ryanrahman27/rocky/model/meshes/hull_gripper_nojaws.stl

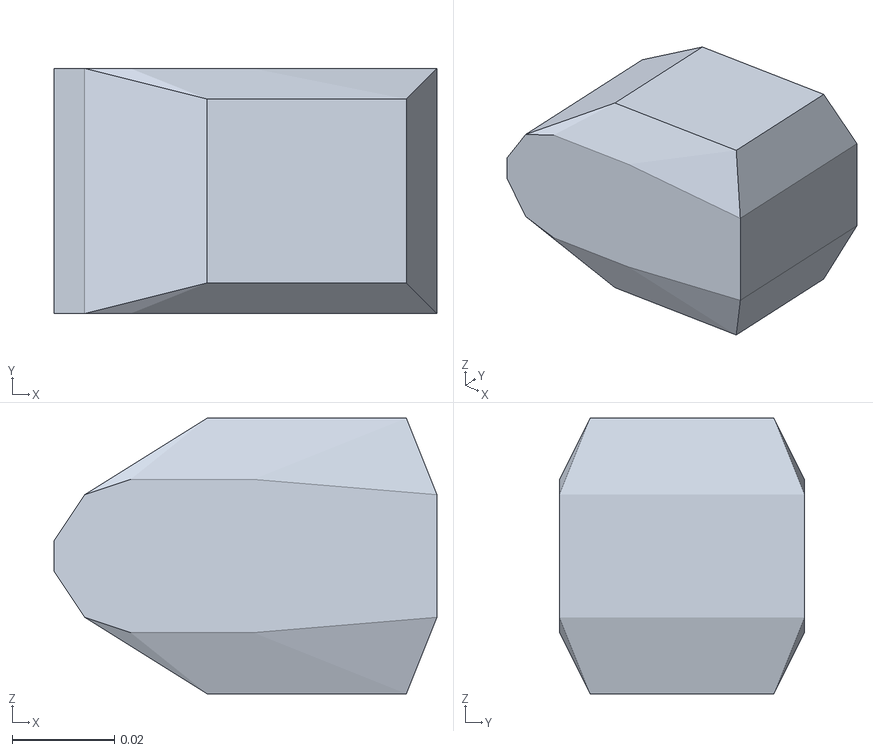
[picture p4: CAD file, 2026-09-15]
model/meshes/hull_gripper_nojaws.stl
0.075 x 0.048 x 0.054
