ryanrahman27/rocky/model/meshes/coxa_l1__F6700ZZ_SweepIdler.stl

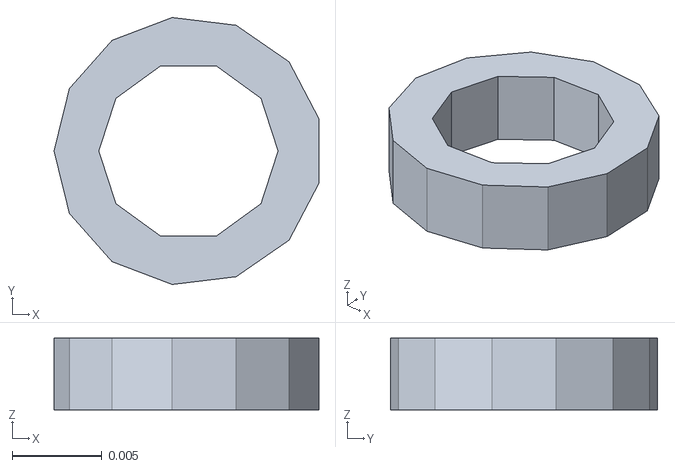
[picture p5: CAD file, 2026-09-13]
model/meshes/coxa_l1__F6700ZZ_SweepIdler.stl
0.0148 x 0.0149 x 0.004
