ryanrahman27/rocky/model/meshes/femur_l1__Horn_Elbow.stl

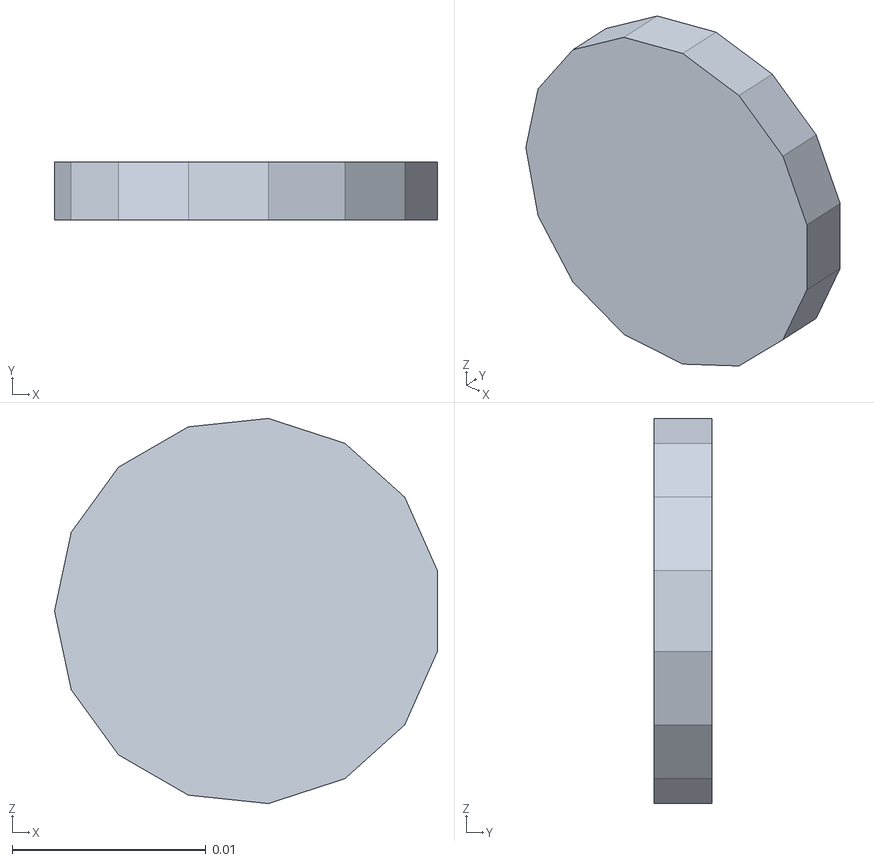
[picture p6: CAD file, 2026-09-13]
model/meshes/femur_l1__Horn_Elbow.stl
0.0198 x 0.003 x 0.0199
