ryanrahman27/rocky/model/meshes/hull_tibia_m.stl

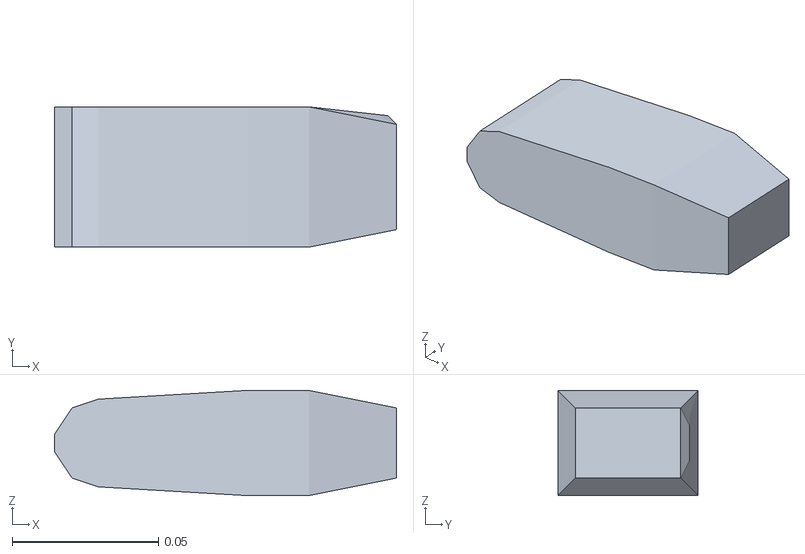
[picture p7: CAD file, 2026-09-13]
model/meshes/hull_tibia_m.stl
0.117 x 0.048 x 0.036
