ryanrahman27/rocky/model/meshes/hull_tibia.stl

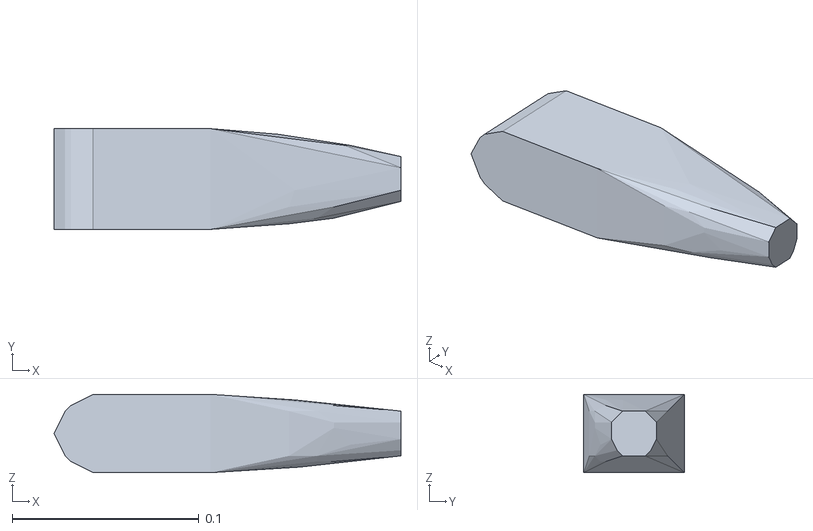
[picture p8: CAD file, 2026-09-13]
model/meshes/hull_tibia.stl
0.186 x 0.054 x 0.042
