ryanrahman27/rocky/model/meshes/base__Shoulder_Boot_3.stl

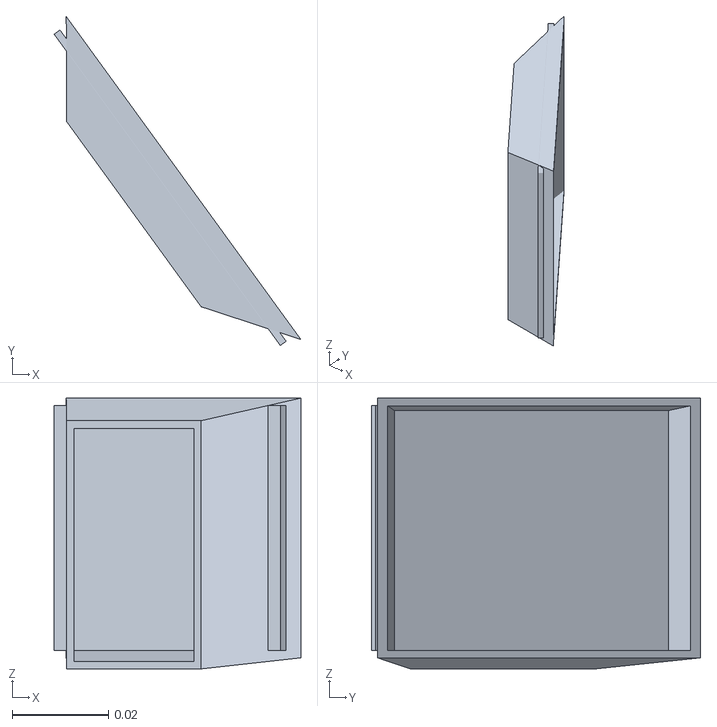
[picture p9: CAD file, 2026-09-13]
model/meshes/base__Shoulder_Boot_3.stl
0.0513 x 0.0684 x 0.0563
