ryanrahman27/rocky/model/meshes/femur_l1__Femur_Sleeve_Top.stl

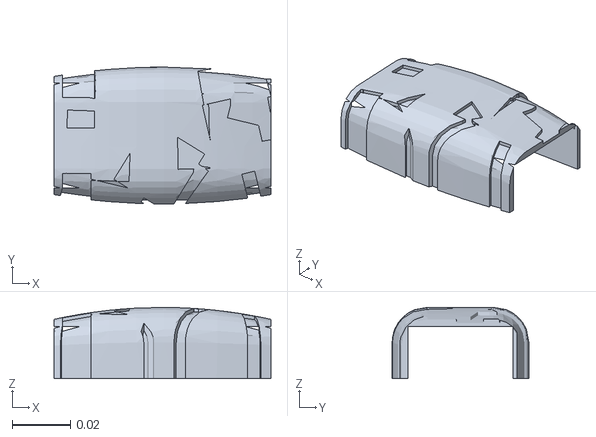
[picture p10: CAD file, 2026-09-13]
model/meshes/femur_l1__Femur_Sleeve_Top.stl
0.0746 x 0.047 x 0.0244
