ryanrahman27/rocky/model/meshes/tibia_m0__STS3215_Wrist.stl

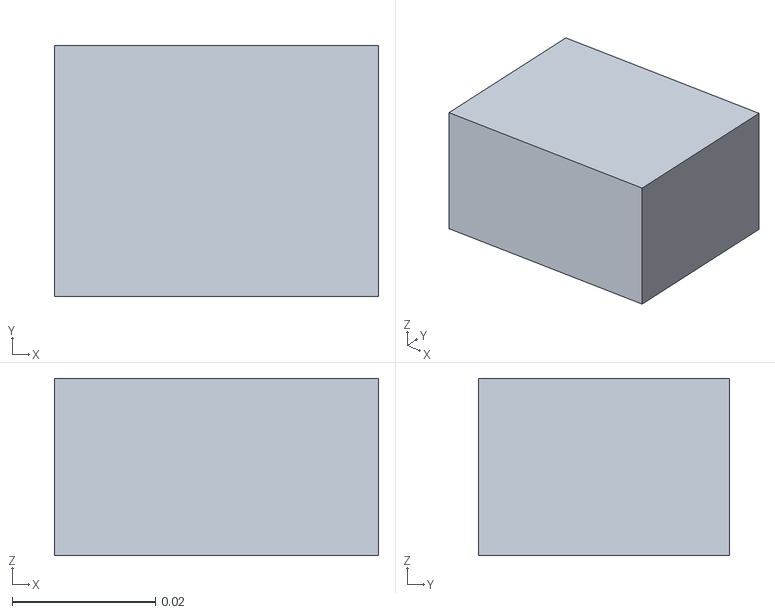
[picture p11: CAD file, 2026-09-13]
model/meshes/tibia_m0__STS3215_Wrist.stl
0.0452 x 0.035 x 0.0247
