ryanrahman27/rocky/model/meshes/base__Shoulder_Boot_4.stl

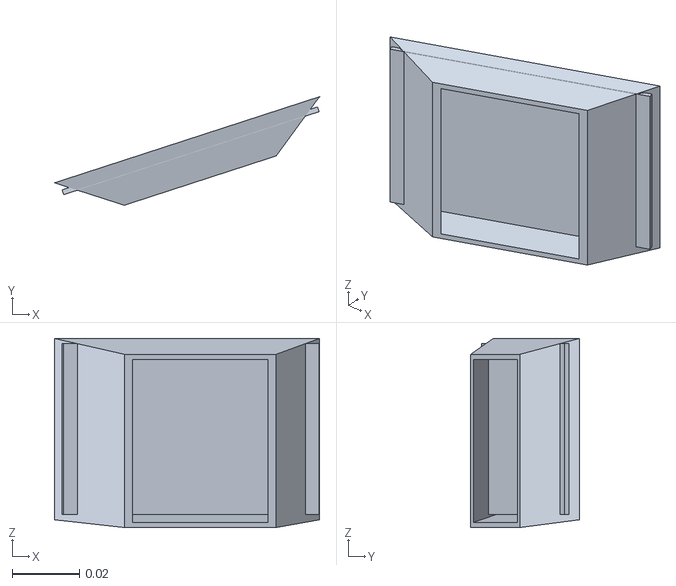
[picture p12: CAD file, 2026-09-13]
model/meshes/base__Shoulder_Boot_4.stl
0.0789 x 0.0323 x 0.0563
