ryanrahman27/rocky/model/meshes/tibia_l1__TactileSwitch_6x6.stl

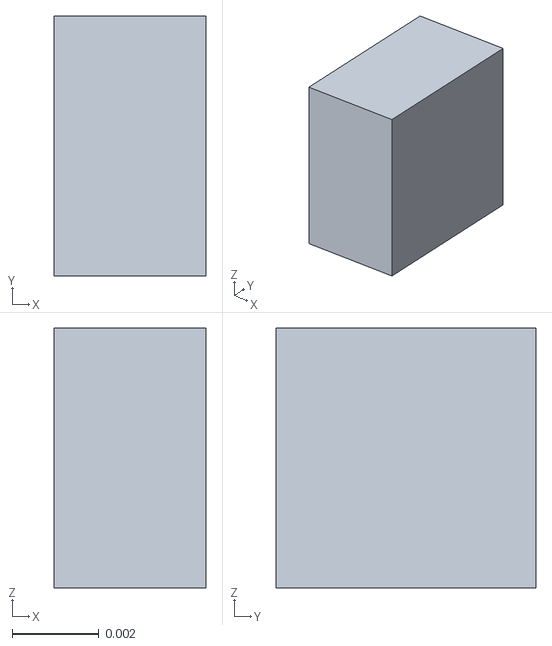
[picture p13: CAD file, 2026-09-13]
model/meshes/tibia_l1__TactileSwitch_6x6.stl
0.0035 x 0.006 x 0.006
