ryanrahman27/rocky/model/meshes/tibia_l1__Tibia_Sleeve_Top.stl

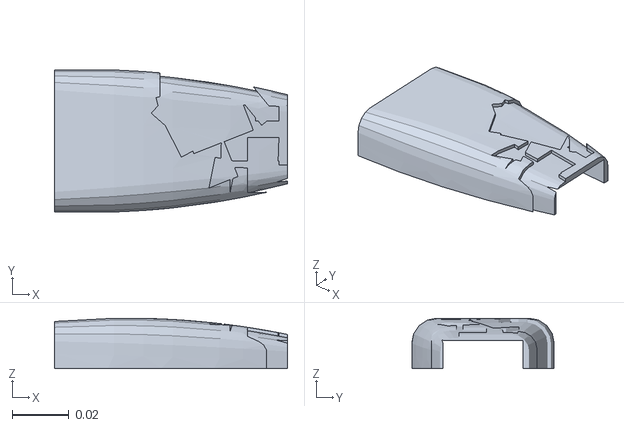
[picture p14: CAD file, 2026-09-13]
model/meshes/tibia_l1__Tibia_Sleeve_Top.stl
0.0818 x 0.05 x 0.0177
