ryanrahman27/rocky/model/meshes/gripper_m0__Jaw_L.stl

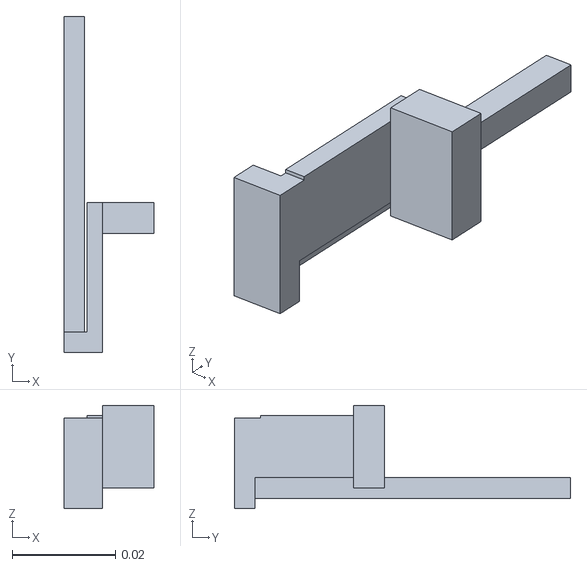
[picture p15: CAD file, 2026-09-13]
model/meshes/gripper_m0__Jaw_L.stl
0.0175 x 0.065 x 0.02
