ryanrahman27/rocky/model/meshes/gripper_m0__Foot_Pad_Manip.stl

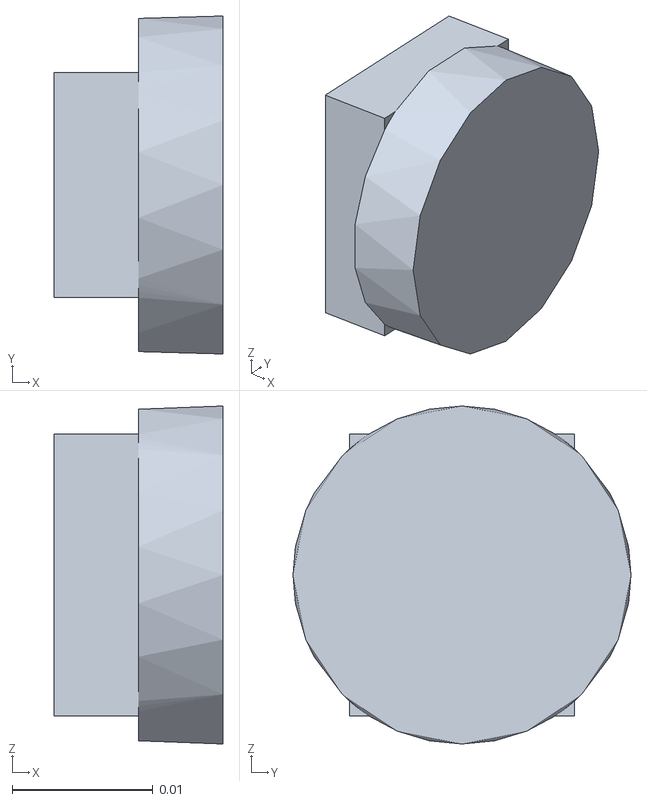
[picture p16: CAD file, 2026-09-13]
model/meshes/gripper_m0__Foot_Pad_Manip.stl
0.012 x 0.024 x 0.024
