ryanrahman27/rocky/model/meshes/hull_femur.stl

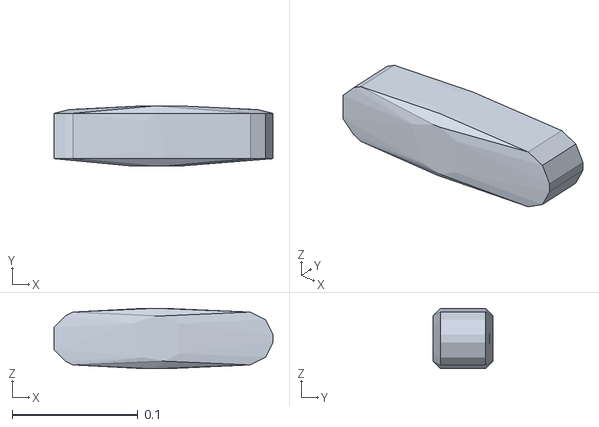
[picture p17: CAD file, 2026-09-13]
model/meshes/hull_femur.stl
0.174 x 0.048 x 0.048
