ryanrahman27/rocky/model/meshes/tibia_m0__Tibia_Manip.stl

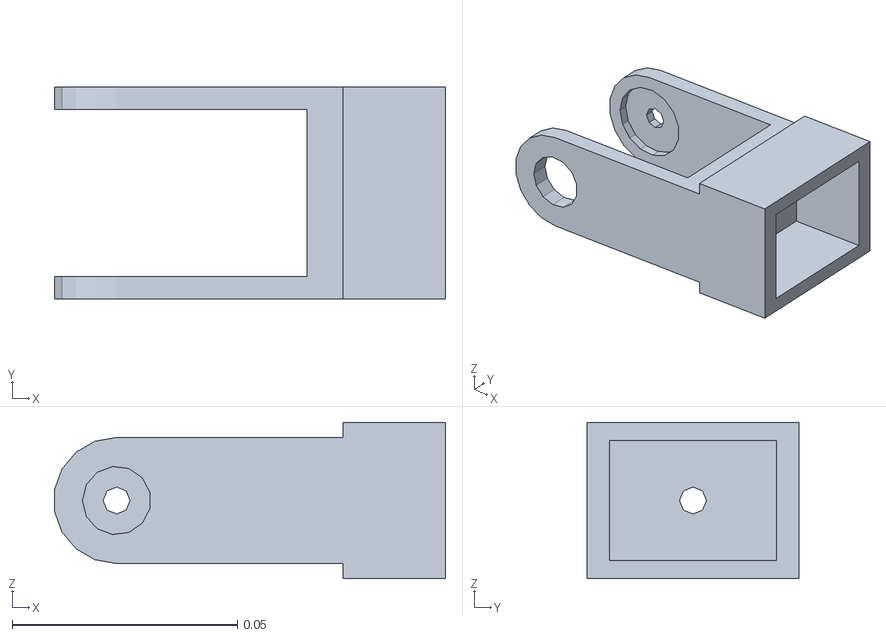
[picture p18: CAD file, 2026-09-13]
model/meshes/tibia_m0__Tibia_Manip.stl
0.0868 x 0.047 x 0.0347
