ryanrahman27/rocky/model/meshes/hull_gripper.stl

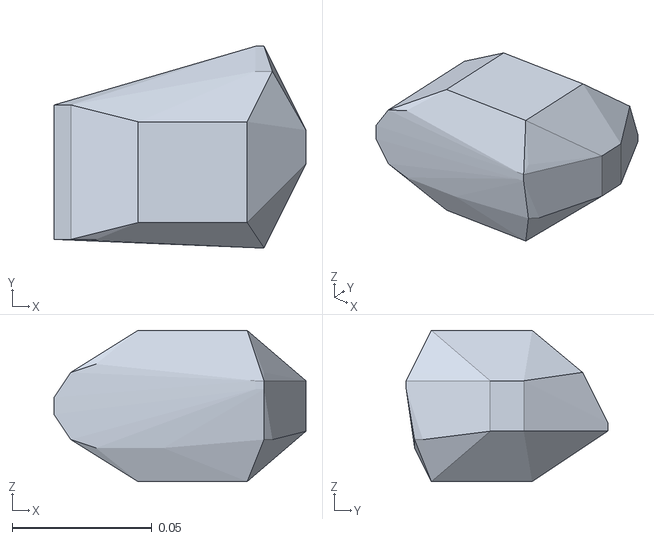
[picture p19: CAD file, 2026-09-13]
model/meshes/hull_gripper.stl
0.09 x 0.072 x 0.054
