ryanrahman27/rocky/model/meshes/base__Shoulder_Boot.stl

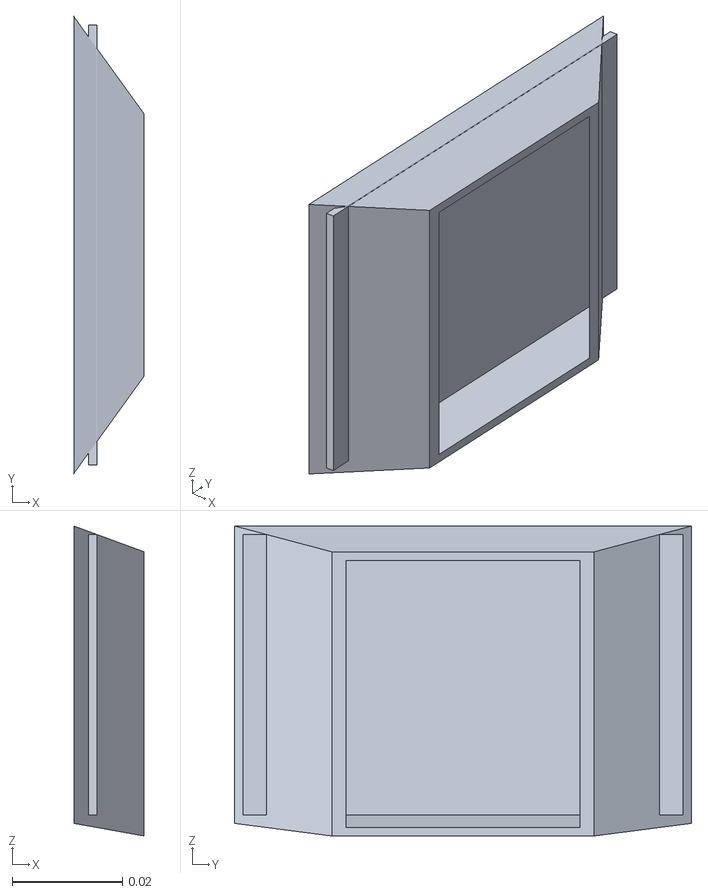
[picture p20: CAD file, 2026-09-13]
model/meshes/base__Shoulder_Boot.stl
0.0128 x 0.083 x 0.0563
