ryanrahman27/rocky/model/meshes/base__Chassis.stl

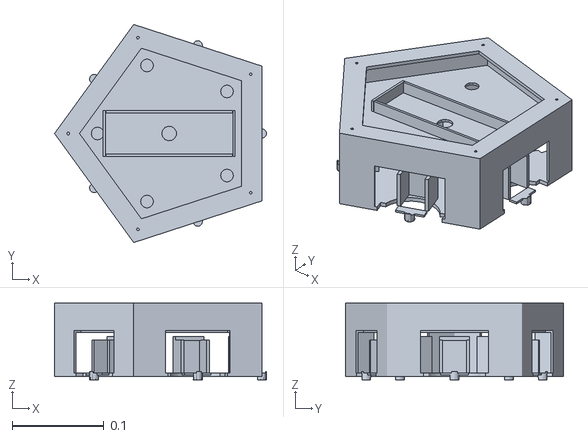
[picture p21: CAD file, 2026-09-13]
model/meshes/base__Chassis.stl
0.231 x 0.238 x 0.0835
