ryanrahman27/rocky/model/meshes/tibia_l1__Claw_Foot.stl

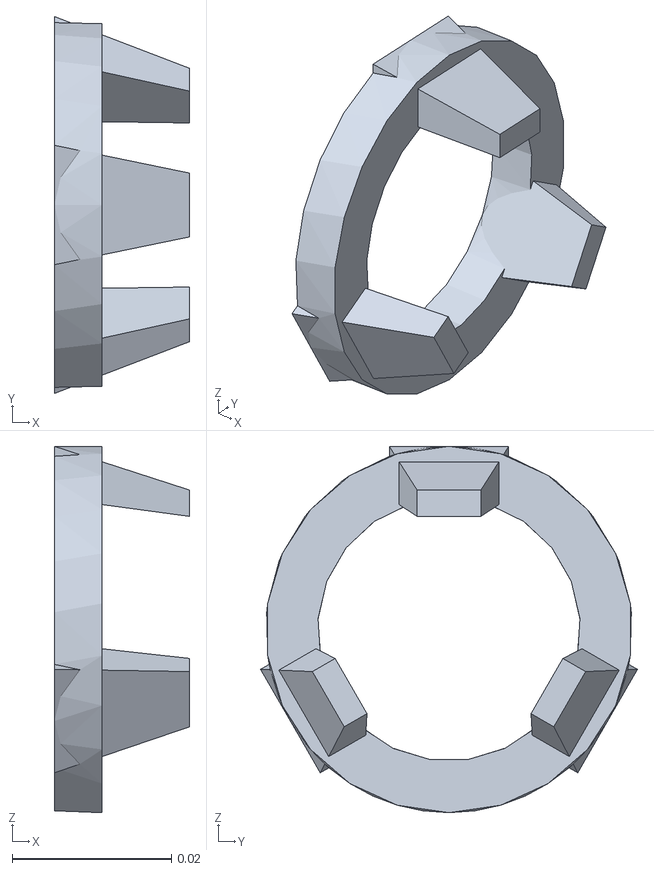
[picture p22: CAD file, 2026-09-13]
model/meshes/tibia_l1__Claw_Foot.stl
0.017 x 0.0473 x 0.046
