ryanrahman27/rocky/model/meshes/gripper_m0__Gripper_Base.stl

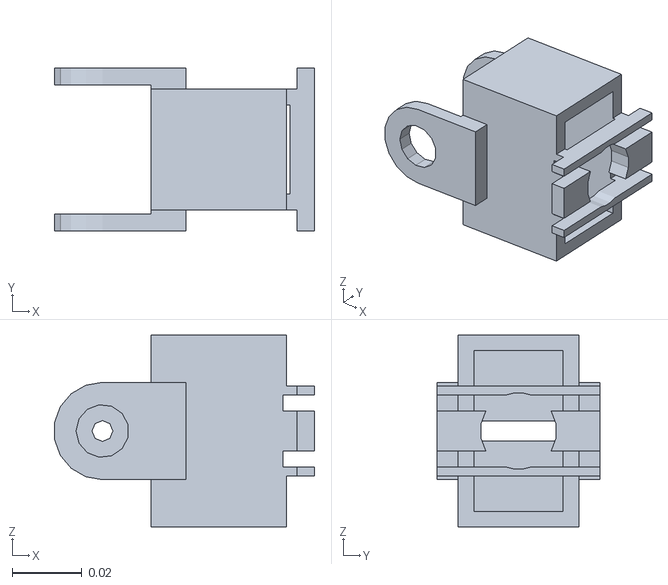
[picture p23: CAD file, 2026-09-13]
model/meshes/gripper_m0__Gripper_Base.stl
0.0748 x 0.047 x 0.0552
