ryanrahman27/rocky/model/meshes/coxa_l1__Shoulder_Cap.stl

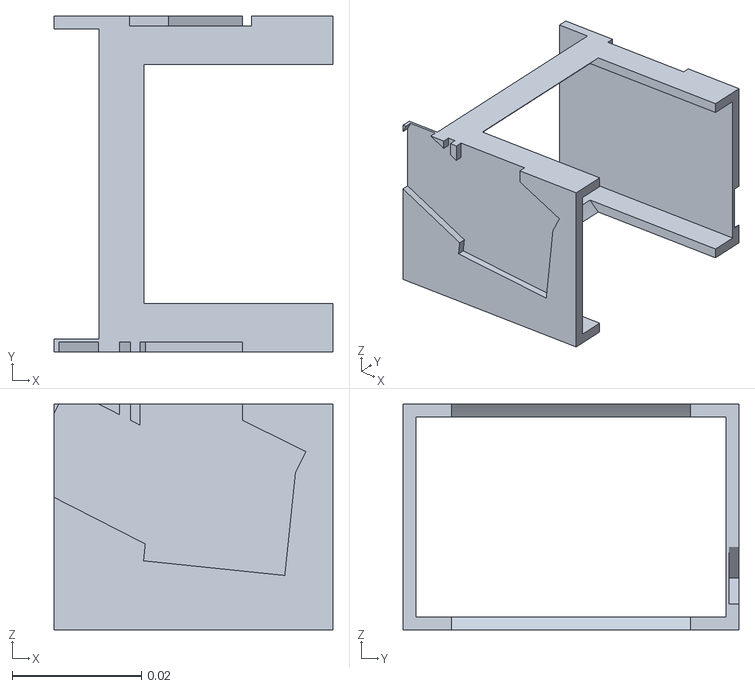
[picture p24: CAD file, 2026-09-13]
model/meshes/coxa_l1__Shoulder_Cap.stl
0.0432 x 0.052 x 0.035
