ryanrahman27/rocky/model/meshes/tibia_l1__Knee_Cap.stl

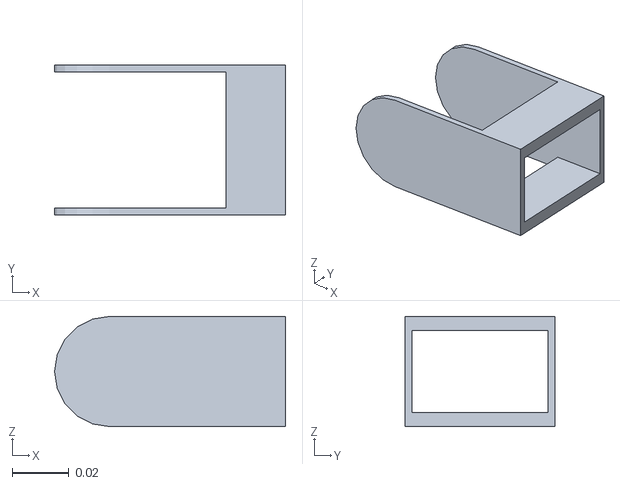
[picture p25: CAD file, 2026-09-13]
model/meshes/tibia_l1__Knee_Cap.stl
0.0817 x 0.053 x 0.039
