ryanrahman27/rocky/model/meshes/hull_coxa.stl

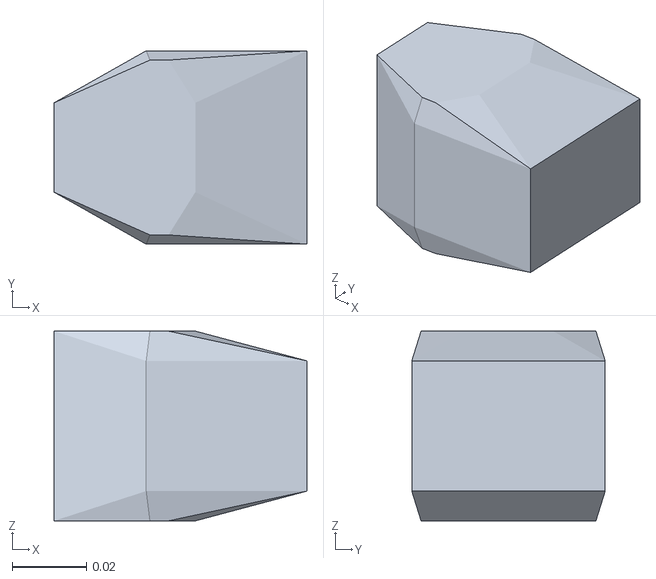
[picture p26: CAD file, 2026-09-13]
model/meshes/hull_coxa.stl
0.068 x 0.052 x 0.051
