ryanrahman27/rocky/model/meshes/coxa_l1__Coxa_Bracket.stl

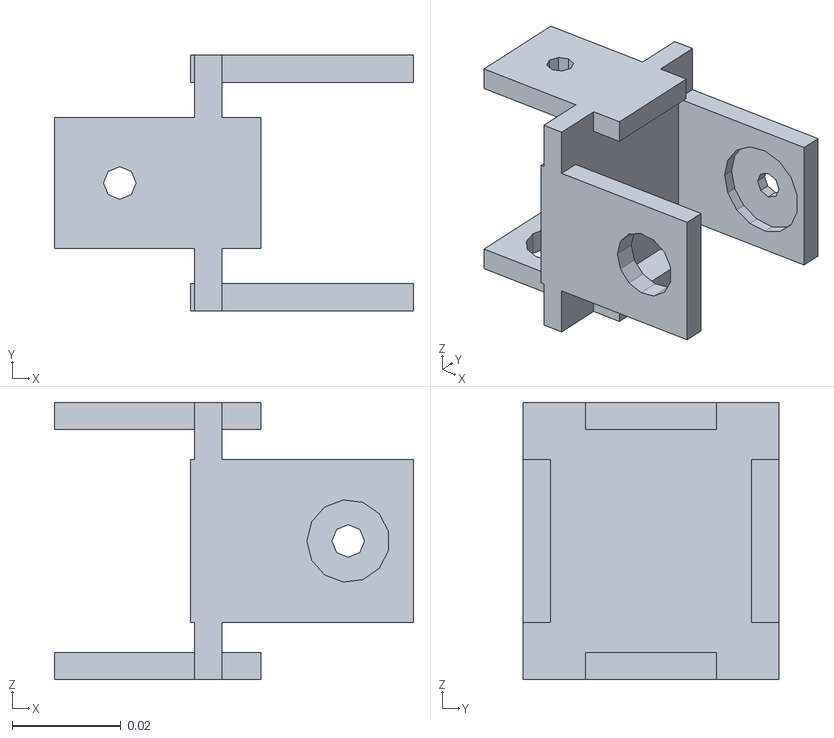
[picture p27: CAD file, 2026-09-13]
model/meshes/coxa_l1__Coxa_Bracket.stl
0.066 x 0.047 x 0.051
