ryanrahman27/rocky/model/meshes/tibia_l1__Tibia.stl

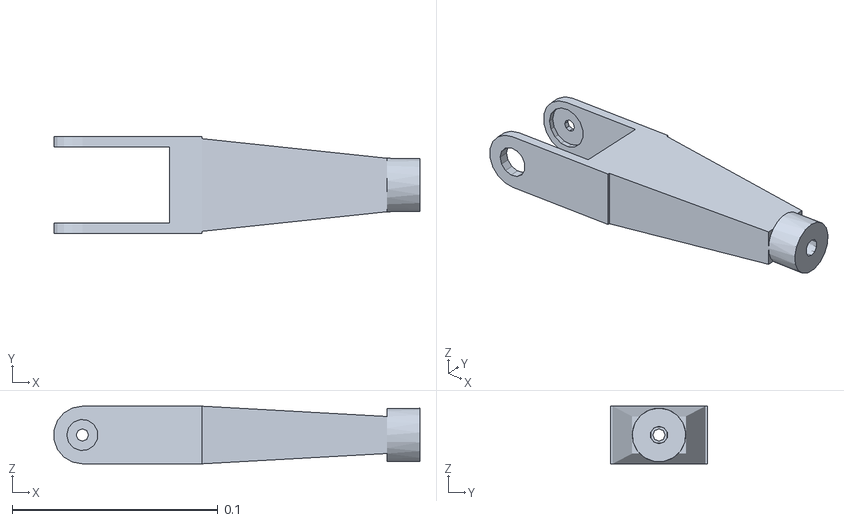
[picture p28: CAD file, 2026-09-13]
model/meshes/tibia_l1__Tibia.stl
0.178 x 0.047 x 0.028
