ryanrahman27/rocky/model/meshes/hull_base.stl

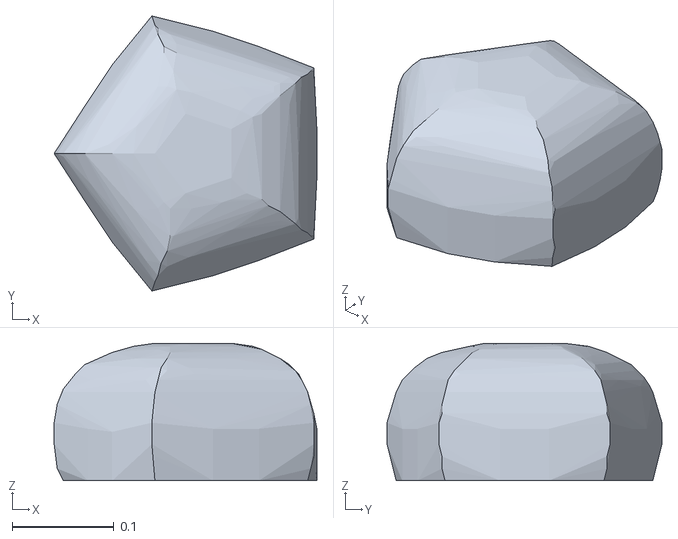
[picture p29: CAD file, 2026-09-13]
model/meshes/hull_base.stl
0.258 x 0.27 x 0.135
