ryanrahman27/rocky/model/meshes/tibia_l1__Plunger_Pin.stl

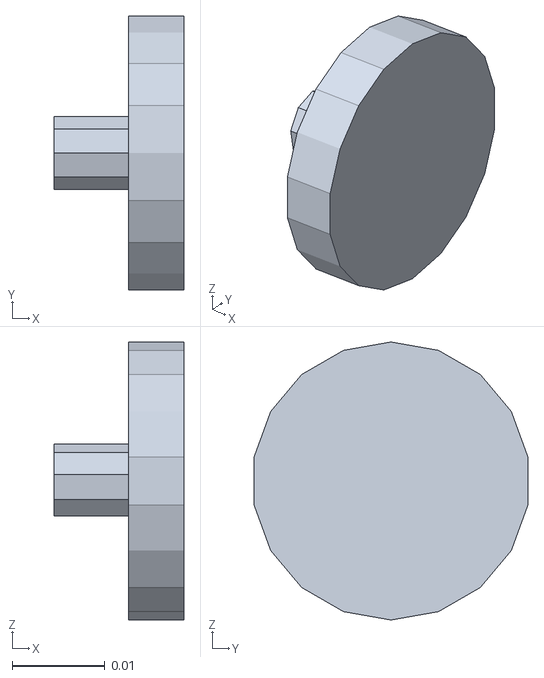
[picture p30: CAD file, 2026-09-13]
model/meshes/tibia_l1__Plunger_Pin.stl
0.014 x 0.0295 x 0.03
