ryanrahman27/rocky/model/meshes/gripper_m0__Pinion_12T.stl

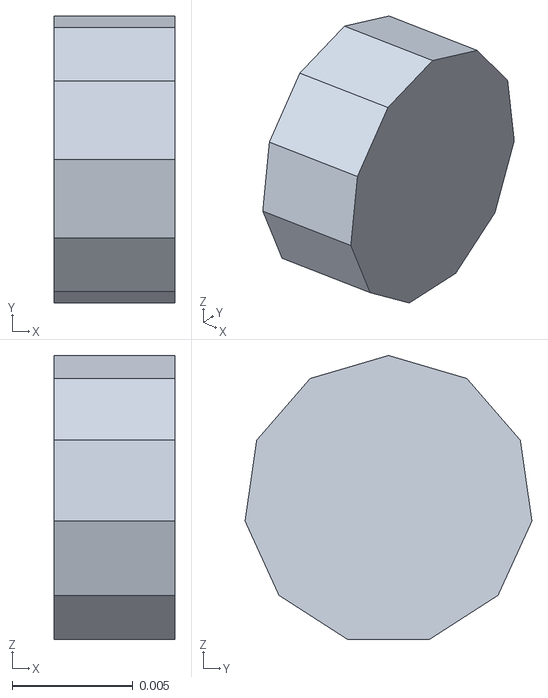
[picture p31: CAD file, 2026-09-13]
model/meshes/gripper_m0__Pinion_12T.stl
0.005 x 0.0119 x 0.0118
