ryanrahman27/rocky/model/meshes/femur_l1__Femur_Shell.stl

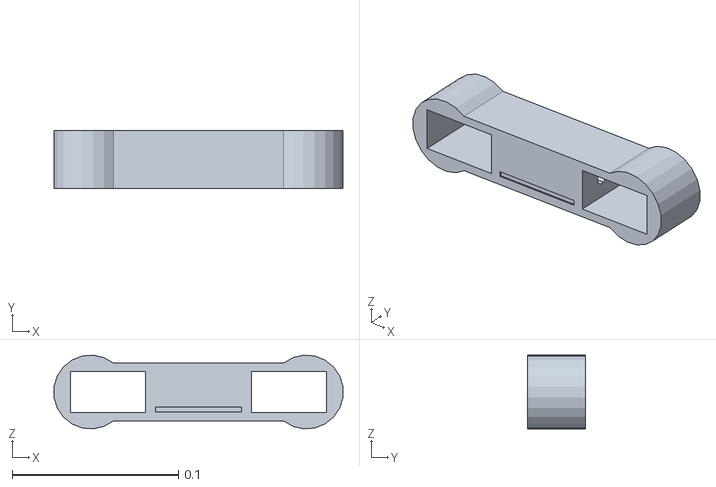
[picture p32: CAD file, 2026-09-13]
model/meshes/femur_l1__Femur_Shell.stl
0.174 x 0.035 x 0.0443
