ryanrahman27/rocky/model/meshes/base__Carapace.stl

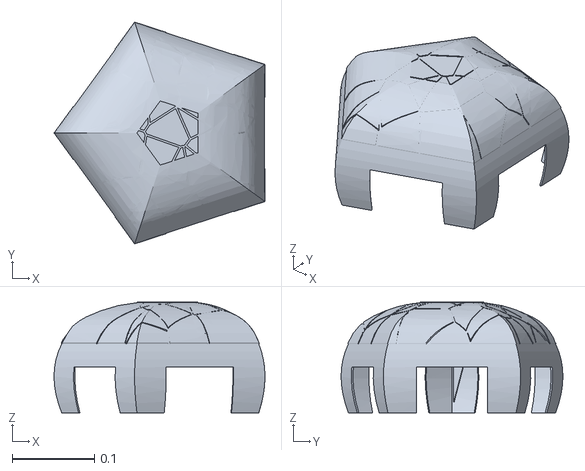
[picture p33: CAD file, 2026-09-13]
model/meshes/base__Carapace.stl
0.257 x 0.27 x 0.135
