ryanrahman27/rocky/(list of files, cad)

Other CAD files:
model/meshes/tibia_m0__F6700ZZ_ElbowIdler.stl
model/meshes/tibia_l1__F6700ZZ_ElbowIdler.stl
model/meshes/base__Shoulder_Boot_2.stl
model/meshes/gripper_m0__Horn_Gripper.stl
model/meshes/gripper_m0__Jaw_R.stl
model/meshes/femur_l1__Femur_Sleeve_Bottom.stl
model/meshes/femur_l1__Horn_Lift.stl
model/meshes/tibia_m0__Horn_Wrist.stl
model/meshes/gripper_m0__STS3215_Gripper.stl
model/meshes/gripper_m0__F6700ZZ_WristIdler.stl
model/meshes/femur_l1__STS3215_Elbow.stl
model/meshes/coxa_l1__F6700ZZ_LiftIdler.stl
model/meshes/femur_l1__STS3215_Lift.stl
model/meshes/tibia_l1__Tibia_Sleeve_Bottom.stl
model/meshes/base__Shoulder_Boot_1.stl
