ryanrahman27/rocky/model/rocky.urdf

<?xml version="1.0"?>
<robot name="rocky">
  <mujoco><compiler meshdir="" balanceinertia="true" discardvisual="false" strippath="false"/></mujoco>
  <material name="sandstone"><color rgba="0.588 0.455 0.329 1"/></material>
  <material name="sandstone_dark"><color rgba="0.376 0.290 0.212 1"/></material>
  <material name="metal"><color rgba="0.25 0.25 0.27 1"/></material>
  <material name="rubber"><color rgba="0.12 0.11 0.10 1"/></material>
  <link name="base_link">
    <inertial>
      <origin xyz="0.0001749761 -0.0000434770 0.0527797235"/>
      <mass value="1.3323345375"/>
      <inertia ixx="0.00563132765455" ixy="1.18792858478e-05" ixz="6.73435054842e-06" iyy="0.00617944523274" iyz="-3.19068712785e-06" izz="0.00885178962494"/>
    </inertial>
    <visual>
      <geometry><mesh filename="meshes/base__Chassis.stl"/></geometry>
      <material name="sandstone_dark"/>
    </visual>
    <visual>
      <geometry><mesh filename="meshes/base__Carapace.stl"/></geometry>
      <material name="sandstone"/>
    </visual>
    <visual>
      <geometry><mesh filename="meshes/base__Shoulder_Boot.stl"/></geometry>
      <material name="rubber"/>
    </visual>
    <visual>
      <geometry><mesh filename="meshes/base__Shoulder_Boot_1.stl"/></geometry>
      <material name="rubber"/>
    </visual>
    <visual>
      <geometry><mesh filename="meshes/base__Shoulder_Boot_2.stl"/></geometry>
      <material name="rubber"/>
    </visual>
    <visual>
      <geometry><mesh filename="meshes/base__Shoulder_Boot_3.stl"/></geometry>
      <material name="rubber"/>
    </visual>
    <visual>
      <geometry><mesh filename="meshes/base__Shoulder_Boot_4.stl"/></geometry>
      <material name="rubber"/>
    </visual>
    <collision>
      <geometry><mesh filename="meshes/hull_base.stl"/></geometry>
    </collision>
  </link>
  <link name="coxa_0">
    <inertial>
      <origin xyz="0.0220536062 -0.0019426100 -0.0017121492"/>
      <mass value="0.0513195740"/>
      <inertia ixx="2.66251964914e-05" ixy="2.03394448522e-06" ixz="-1.75072383268e-06" iyy="2.59360418573e-05" iyz="2.06874025331e-08" izz="2.73187075064e-05"/>
    </inertial>
    <visual>
      <geometry><mesh filename="meshes/coxa_l1__Coxa_Bracket.stl"/></geometry>
      <material name="sandstone_dark"/>
    </visual>
    <visual>
      <geometry><mesh filename="meshes/coxa_l1__F6700ZZ_SweepIdler.stl"/></geometry>
      <material name="metal"/>
    </visual>
    <visual>
      <geometry><mesh filename="meshes/coxa_l1__F6700ZZ_LiftIdler.stl"/></geometry>
      <material name="metal"/>
    </visual>
    <visual>
      <geometry><mesh filename="meshes/coxa_l1__Shoulder_Cap.stl"/></geometry>
      <material name="sandstone"/>
    </visual>
    <collision>
      <geometry><mesh filename="meshes/hull_coxa.stl"/></geometry>
    </collision>
  </link>
  <link name="femur_0">
    <inertial>
      <origin xyz="0.0641940239 0.0000510935 0.0001382543"/>
      <mass value="0.3104070510"/>
      <inertia ixx="8.81913648521e-05" ixy="6.02727799994e-07" ixz="4.02792124591e-07" iyy="0.000816480742233" iyz="5.14032825426e-09" izz="0.000812937154262"/>
    </inertial>
    <visual>
      <geometry><mesh filename="meshes/femur_l1__Femur_Shell.stl"/></geometry>
      <material name="sandstone_dark"/>
    </visual>
    <visual>
      <geometry><mesh filename="meshes/femur_l1__STS3215_Lift.stl"/></geometry>
      <material name="metal"/>
    </visual>
    <visual>
      <geometry><mesh filename="meshes/femur_l1__STS3215_Elbow.stl"/></geometry>
      <material name="metal"/>
    </visual>
    <visual>
      <geometry><mesh filename="meshes/femur_l1__Horn_Lift.stl"/></geometry>
      <material name="metal"/>
    </visual>
    <visual>
      <geometry><mesh filename="meshes/femur_l1__Horn_Elbow.stl"/></geometry>
      <material name="metal"/>
    </visual>
    <visual>
      <geometry><mesh filename="meshes/femur_l1__Femur_Sleeve_Bottom.stl"/></geometry>
      <material name="sandstone"/>
    </visual>
    <visual>
      <geometry><mesh filename="meshes/femur_l1__Femur_Sleeve_Top.stl"/></geometry>
      <material name="sandstone"/>
    </visual>
    <collision>
      <geometry><mesh filename="meshes/hull_femur.stl"/></geometry>
    </collision>
  </link>
  <link name="tibia_0">
    <inertial>
      <origin xyz="0.0606282784 -0.0006202666 -0.0000000000"/>
      <mass value="0.1149173802"/>
      <inertia ixx="3.21672869662e-05" ixy="-6.12120479707e-06" ixz="-1.4935611875e-19" iyy="9.46675013848e-05" iyz="-3.66694995021e-20" izz="0.000110302610086"/>
    </inertial>
    <visual>
      <geometry><mesh filename="meshes/tibia_m0__Tibia_Manip.stl"/></geometry>
      <material name="sandstone_dark"/>
    </visual>
    <visual>
      <geometry><mesh filename="meshes/tibia_m0__F6700ZZ_ElbowIdler.stl"/></geometry>
      <material name="metal"/>
    </visual>
    <visual>
      <geometry><mesh filename="meshes/tibia_m0__STS3215_Wrist.stl"/></geometry>
      <material name="metal"/>
    </visual>
    <visual>
      <geometry><mesh filename="meshes/tibia_m0__Horn_Wrist.stl"/></geometry>
      <material name="metal"/>
    </visual>
    <collision>
      <geometry><mesh filename="meshes/hull_tibia_m.stl"/></geometry>
    </collision>
  </link>
  <link name="gripper_0">
    <inertial>
      <origin xyz="0.0351404471 -0.0001979038 0.0000000000"/>
      <mass value="0.1331457011"/>
      <inertia ixx="4.66083182644e-05" ixy="-5.00611665605e-06" ixz="-2.23750063156e-15" iyy="6.91403871936e-05" iyz="-8.47360828886e-09" izz="6.28312573096e-05"/>
    </inertial>
    <visual>
      <geometry><mesh filename="meshes/gripper_m0__Gripper_Base.stl"/></geometry>
      <material name="sandstone_dark"/>
    </visual>
    <visual>
      <geometry><mesh filename="meshes/gripper_m0__Jaw_R.stl"/></geometry>
      <material name="sandstone_dark"/>
    </visual>
    <visual>
      <geometry><mesh filename="meshes/gripper_m0__Jaw_L.stl"/></geometry>
      <material name="sandstone_dark"/>
    </visual>
    <visual>
      <geometry><mesh filename="meshes/gripper_m0__Foot_Pad_Manip.stl"/></geometry>
      <material name="rubber"/>
    </visual>
    <visual>
      <geometry><mesh filename="meshes/gripper_m0__F6700ZZ_WristIdler.stl"/></geometry>
      <material name="metal"/>
    </visual>
    <visual>
      <geometry><mesh filename="meshes/gripper_m0__STS3215_Gripper.stl"/></geometry>
      <material name="metal"/>
    </visual>
    <visual>
      <geometry><mesh filename="meshes/gripper_m0__Horn_Gripper.stl"/></geometry>
      <material name="metal"/>
    </visual>
    <visual>
      <geometry><mesh filename="meshes/gripper_m0__Pinion_12T.stl"/></geometry>
      <material name="metal"/>
    </visual>
    <collision>
      <geometry><mesh filename="meshes/hull_gripper.stl"/></geometry>
    </collision>
    <collision>
      <origin xyz="0.0743601445 0 0"/>
      <geometry><sphere radius="0.0100000000"/></geometry>
    </collision>
  </link>
  <joint name="sweep_0" type="revolute">
    <parent link="base_link"/>
    <child link="coxa_0"/>
    <origin xyz="0.1011271243 0.0000000000 0.0220000000" rpy="0 0 0.0000000000"/>
    <axis xyz="0 0 1"/>
    <limit lower="-0.7853981634" upper="0.7853981634" effort="2.90" velocity="4.70"/>
    <dynamics damping="0.0100" friction="0.0500"/>
  </joint>
  <joint name="lift_0" type="revolute">
    <parent link="coxa_0"/>
    <child link="femur_0"/>
    <origin xyz="0.0420000000 0 0" rpy="0 0 0"/>
    <axis xyz="0 1 0"/>
    <limit lower="-1.3962634016" upper="1.4835298642" effort="2.90" velocity="4.70"/>
    <dynamics damping="0.0100" friction="0.0500"/>
  </joint>
  <joint name="elbow_0" type="revolute">
    <parent link="femur_0"/>
    <child link="tibia_0"/>
    <origin xyz="0.1300000000 0 0" rpy="0 0 0"/>
    <axis xyz="0 1 0"/>
    <limit lower="0.1745329252" upper="2.3561944902" effort="2.90" velocity="4.70"/>
    <dynamics damping="0.0100" friction="0.0500"/>
  </joint>
  <joint name="wrist_0" type="revolute">
    <parent link="tibia_0"/>
    <child link="gripper_0"/>
    <origin xyz="0.0900000000 0 0" rpy="0 0 0"/>
    <axis xyz="0 1 0"/>
    <limit lower="-1.3089969390" upper="1.3089969390" effort="2.90" velocity="4.70"/>
    <dynamics damping="0.0100" friction="0.0500"/>
  </joint>
  <link name="coxa_1">
    <inertial>
      <origin xyz="0.0220536062 -0.0019426100 -0.0017121492"/>
      <mass value="0.0513195740"/>
      <inertia ixx="2.66251964914e-05" ixy="2.03394448522e-06" ixz="-1.75072383268e-06" iyy="2.59360418573e-05" iyz="2.06874025331e-08" izz="2.73187075064e-05"/>
    </inertial>
    <visual>
      <geometry><mesh filename="meshes/coxa_l1__Coxa_Bracket.stl"/></geometry>
      <material name="sandstone_dark"/>
    </visual>
    <visual>
      <geometry><mesh filename="meshes/coxa_l1__F6700ZZ_SweepIdler.stl"/></geometry>
      <material name="metal"/>
    </visual>
    <visual>
      <geometry><mesh filename="meshes/coxa_l1__F6700ZZ_LiftIdler.stl"/></geometry>
      <material name="metal"/>
    </visual>
    <visual>
      <geometry><mesh filename="meshes/coxa_l1__Shoulder_Cap.stl"/></geometry>
      <material name="sandstone"/>
    </visual>
    <collision>
      <geometry><mesh filename="meshes/hull_coxa.stl"/></geometry>
    </collision>
  </link>
  <link name="femur_1">
    <inertial>
      <origin xyz="0.0641940239 0.0000510935 0.0001382543"/>
      <mass value="0.3104070510"/>
      <inertia ixx="8.81913648521e-05" ixy="6.02727799994e-07" ixz="4.02792124591e-07" iyy="0.000816480742233" iyz="5.14032825426e-09" izz="0.000812937154262"/>
    </inertial>
    <visual>
      <geometry><mesh filename="meshes/femur_l1__Femur_Shell.stl"/></geometry>
      <material name="sandstone_dark"/>
    </visual>
    <visual>
      <geometry><mesh filename="meshes/femur_l1__STS3215_Lift.stl"/></geometry>
      <material name="metal"/>
    </visual>
    <visual>
      <geometry><mesh filename="meshes/femur_l1__STS3215_Elbow.stl"/></geometry>
      <material name="metal"/>
    </visual>
    <visual>
      <geometry><mesh filename="meshes/femur_l1__Horn_Lift.stl"/></geometry>
      <material name="metal"/>
    </visual>
    <visual>
      <geometry><mesh filename="meshes/femur_l1__Horn_Elbow.stl"/></geometry>
      <material name="metal"/>
    </visual>
    <visual>
      <geometry><mesh filename="meshes/femur_l1__Femur_Sleeve_Bottom.stl"/></geometry>
      <material name="sandstone"/>
    </visual>
    <visual>
      <geometry><mesh filename="meshes/femur_l1__Femur_Sleeve_Top.stl"/></geometry>
      <material name="sandstone"/>
    </visual>
    <collision>
      <geometry><mesh filename="meshes/hull_femur.stl"/></geometry>
    </collision>
  </link>
  <link name="tibia_1">
    <inertial>
      <origin xyz="0.0794509441 -0.0005404937 -0.0000268868"/>
      <mass value="0.1952924260"/>
      <inertia ixx="7.16375396603e-05" ixy="-6.30207363729e-06" ixz="-3.81130343208e-09" iyy="0.000446757714147" iyz="-3.34732118895e-08" izz="0.00047516971597"/>
    </inertial>
    <visual>
      <geometry><mesh filename="meshes/tibia_l1__Tibia.stl"/></geometry>
      <material name="sandstone_dark"/>
    </visual>
    <visual>
      <geometry><mesh filename="meshes/tibia_l1__F6700ZZ_ElbowIdler.stl"/></geometry>
      <material name="metal"/>
    </visual>
    <visual>
      <geometry><mesh filename="meshes/tibia_l1__TactileSwitch_6x6.stl"/></geometry>
      <material name="metal"/>
    </visual>
    <visual>
      <geometry><mesh filename="meshes/tibia_l1__Tibia_Sleeve_Bottom.stl"/></geometry>
      <material name="sandstone"/>
    </visual>
    <visual>
      <geometry><mesh filename="meshes/tibia_l1__Tibia_Sleeve_Top.stl"/></geometry>
      <material name="sandstone"/>
    </visual>
    <visual>
      <geometry><mesh filename="meshes/tibia_l1__Knee_Cap.stl"/></geometry>
      <material name="sandstone"/>
    </visual>
    <visual>
      <geometry><mesh filename="meshes/tibia_l1__Claw_Foot.stl"/></geometry>
      <material name="sandstone"/>
    </visual>
    <visual>
      <geometry><mesh filename="meshes/tibia_l1__Plunger_Pin.stl"/></geometry>
      <material name="rubber"/>
    </visual>
    <collision>
      <geometry><mesh filename="meshes/hull_tibia.stl"/></geometry>
    </collision>
    <collision>
      <origin xyz="0.1622572343 0 0"/>
      <geometry><sphere radius="0.0120000000"/></geometry>
    </collision>
  </link>
  <joint name="sweep_1" type="revolute">
    <parent link="base_link"/>
    <child link="coxa_1"/>
    <origin xyz="0.0312500000 0.0961776105 0.0220000000" rpy="0 0 1.2566370614"/>
    <axis xyz="0 0 1"/>
    <limit lower="-0.7853981634" upper="0.7853981634" effort="2.90" velocity="4.70"/>
    <dynamics damping="0.0100" friction="0.0500"/>
  </joint>
  <joint name="lift_1" type="revolute">
    <parent link="coxa_1"/>
    <child link="femur_1"/>
    <origin xyz="0.0420000000 0 0" rpy="0 0 0"/>
    <axis xyz="0 1 0"/>
    <limit lower="-1.3962634016" upper="1.4835298642" effort="2.90" velocity="4.70"/>
    <dynamics damping="0.0100" friction="0.0500"/>
  </joint>
  <joint name="elbow_1" type="revolute">
    <parent link="femur_1"/>
    <child link="tibia_1"/>
    <origin xyz="0.1300000000 0 0" rpy="0 0 0"/>
    <axis xyz="0 1 0"/>
    <limit lower="0.1745329252" upper="2.2689280276" effort="2.90" velocity="4.70"/>
    <dynamics damping="0.0100" friction="0.0500"/>
  </joint>
  <link name="coxa_2">
    <inertial>
      <origin xyz="0.0220536062 -0.0019426100 -0.0017121492"/>
      <mass value="0.0513195740"/>
      <inertia ixx="2.66251964914e-05" ixy="2.03394448522e-06" ixz="-1.75072383268e-06" iyy="2.59360418573e-05" iyz="2.06874025331e-08" izz="2.73187075064e-05"/>
    </inertial>
    <visual>
      <geometry><mesh filename="meshes/coxa_l1__Coxa_Bracket.stl"/></geometry>
      <material name="sandstone_dark"/>
    </visual>
    <visual>
      <geometry><mesh filename="meshes/coxa_l1__F6700ZZ_SweepIdler.stl"/></geometry>
      <material name="metal"/>
    </visual>
    <visual>
      <geometry><mesh filename="meshes/coxa_l1__F6700ZZ_LiftIdler.stl"/></geometry>
      <material name="metal"/>
    </visual>
    <visual>
      <geometry><mesh filename="meshes/coxa_l1__Shoulder_Cap.stl"/></geometry>
      <material name="sandstone"/>
    </visual>
    <collision>
      <geometry><mesh filename="meshes/hull_coxa.stl"/></geometry>
    </collision>
  </link>
  <link name="femur_2">
    <inertial>
      <origin xyz="0.0641940239 0.0000510935 0.0001382543"/>
      <mass value="0.3104070510"/>
      <inertia ixx="8.81913648521e-05" ixy="6.02727799994e-07" ixz="4.02792124591e-07" iyy="0.000816480742233" iyz="5.14032825426e-09" izz="0.000812937154262"/>
    </inertial>
    <visual>
      <geometry><mesh filename="meshes/femur_l1__Femur_Shell.stl"/></geometry>
      <material name="sandstone_dark"/>
    </visual>
    <visual>
      <geometry><mesh filename="meshes/femur_l1__STS3215_Lift.stl"/></geometry>
      <material name="metal"/>
    </visual>
    <visual>
      <geometry><mesh filename="meshes/femur_l1__STS3215_Elbow.stl"/></geometry>
      <material name="metal"/>
    </visual>
    <visual>
      <geometry><mesh filename="meshes/femur_l1__Horn_Lift.stl"/></geometry>
      <material name="metal"/>
    </visual>
    <visual>
      <geometry><mesh filename="meshes/femur_l1__Horn_Elbow.stl"/></geometry>
      <material name="metal"/>
    </visual>
    <visual>
      <geometry><mesh filename="meshes/femur_l1__Femur_Sleeve_Bottom.stl"/></geometry>
      <material name="sandstone"/>
    </visual>
    <visual>
      <geometry><mesh filename="meshes/femur_l1__Femur_Sleeve_Top.stl"/></geometry>
      <material name="sandstone"/>
    </visual>
    <collision>
      <geometry><mesh filename="meshes/hull_femur.stl"/></geometry>
    </collision>
  </link>
  <link name="tibia_2">
    <inertial>
      <origin xyz="0.0794509441 -0.0005404937 -0.0000268868"/>
      <mass value="0.1952924260"/>
      <inertia ixx="7.16375396603e-05" ixy="-6.30207363729e-06" ixz="-3.81130343208e-09" iyy="0.000446757714147" iyz="-3.34732118895e-08" izz="0.00047516971597"/>
    </inertial>
    <visual>
      <geometry><mesh filename="meshes/tibia_l1__Tibia.stl"/></geometry>
      <material name="sandstone_dark"/>
    </visual>
    <visual>
      <geometry><mesh filename="meshes/tibia_l1__F6700ZZ_ElbowIdler.stl"/></geometry>
      <material name="metal"/>
    </visual>
    <visual>
      <geometry><mesh filename="meshes/tibia_l1__TactileSwitch_6x6.stl"/></geometry>
      <material name="metal"/>
    </visual>
    <visual>
      <geometry><mesh filename="meshes/tibia_l1__Tibia_Sleeve_Bottom.stl"/></geometry>
      <material name="sandstone"/>
    </visual>
    <visual>
      <geometry><mesh filename="meshes/tibia_l1__Tibia_Sleeve_Top.stl"/></geometry>
      <material name="sandstone"/>
    </visual>
    <visual>
      <geometry><mesh filename="meshes/tibia_l1__Knee_Cap.stl"/></geometry>
      <material name="sandstone"/>
    </visual>
    <visual>
      <geometry><mesh filename="meshes/tibia_l1__Claw_Foot.stl"/></geometry>
      <material name="sandstone"/>
    </visual>
    <visual>
      <geometry><mesh filename="meshes/tibia_l1__Plunger_Pin.stl"/></geometry>
      <material name="rubber"/>
    </visual>
    <collision>
      <geometry><mesh filename="meshes/hull_tibia.stl"/></geometry>
    </collision>
    <collision>
      <origin xyz="0.1622572343 0 0"/>
      <geometry><sphere radius="0.0120000000"/></geometry>
    </collision>
  </link>
  <joint name="sweep_2" type="revolute">
    <parent link="base_link"/>
    <child link="coxa_2"/>
    <origin xyz="-0.0818135621 0.0594410323 0.0220000000" rpy="0 0 2.5132741229"/>
    <axis xyz="0 0 1"/>
    <limit lower="-0.7853981634" upper="0.7853981634" effort="2.90" velocity="4.70"/>
    <dynamics damping="0.0100" friction="0.0500"/>
  </joint>
  <joint name="lift_2" type="revolute">
    <parent link="coxa_2"/>
    <child link="femur_2"/>
    <origin xyz="0.0420000000 0 0" rpy="0 0 0"/>
    <axis xyz="0 1 0"/>
    <limit lower="-1.3962634016" upper="1.4835298642" effort="2.90" velocity="4.70"/>
    <dynamics damping="0.0100" friction="0.0500"/>
  </joint>
  <joint name="elbow_2" type="revolute">
    <parent link="femur_2"/>
    <child link="tibia_2"/>
    <origin xyz="0.1300000000 0 0" rpy="0 0 0"/>
    <axis xyz="0 1 0"/>
    <limit lower="0.1745329252" upper="2.2689280276" effort="2.90" velocity="4.70"/>
    <dynamics damping="0.0100" friction="0.0500"/>
  </joint>
  <link name="coxa_3">
    <inertial>
      <origin xyz="0.0220536062 -0.0019426100 -0.0017121492"/>
      <mass value="0.0513195740"/>
      <inertia ixx="2.66251964914e-05" ixy="2.03394448522e-06" ixz="-1.75072383268e-06" iyy="2.59360418573e-05" iyz="2.06874025331e-08" izz="2.73187075064e-05"/>
    </inertial>
    <visual>
      <geometry><mesh filename="meshes/coxa_l1__Coxa_Bracket.stl"/></geometry>
      <material name="sandstone_dark"/>
    </visual>
    <visual>
      <geometry><mesh filename="meshes/coxa_l1__F6700ZZ_SweepIdler.stl"/></geometry>
      <material name="metal"/>
    </visual>
    <visual>
      <geometry><mesh filename="meshes/coxa_l1__F6700ZZ_LiftIdler.stl"/></geometry>
      <material name="metal"/>
    </visual>
    <visual>
      <geometry><mesh filename="meshes/coxa_l1__Shoulder_Cap.stl"/></geometry>
      <material name="sandstone"/>
    </visual>
    <collision>
      <geometry><mesh filename="meshes/hull_coxa.stl"/></geometry>
    </collision>
  </link>
  <link name="femur_3">
    <inertial>
      <origin xyz="0.0641940239 0.0000510935 0.0001382543"/>
      <mass value="0.3104070510"/>
      <inertia ixx="8.81913648521e-05" ixy="6.02727799994e-07" ixz="4.02792124591e-07" iyy="0.000816480742233" iyz="5.14032825426e-09" izz="0.000812937154262"/>
    </inertial>
    <visual>
      <geometry><mesh filename="meshes/femur_l1__Femur_Shell.stl"/></geometry>
      <material name="sandstone_dark"/>
    </visual>
    <visual>
      <geometry><mesh filename="meshes/femur_l1__STS3215_Lift.stl"/></geometry>
      <material name="metal"/>
    </visual>
    <visual>
      <geometry><mesh filename="meshes/femur_l1__STS3215_Elbow.stl"/></geometry>
      <material name="metal"/>
    </visual>
    <visual>
      <geometry><mesh filename="meshes/femur_l1__Horn_Lift.stl"/></geometry>
      <material name="metal"/>
    </visual>
    <visual>
      <geometry><mesh filename="meshes/femur_l1__Horn_Elbow.stl"/></geometry>
      <material name="metal"/>
    </visual>
    <visual>
      <geometry><mesh filename="meshes/femur_l1__Femur_Sleeve_Bottom.stl"/></geometry>
      <material name="sandstone"/>
    </visual>
    <visual>
      <geometry><mesh filename="meshes/femur_l1__Femur_Sleeve_Top.stl"/></geometry>
      <material name="sandstone"/>
    </visual>
    <collision>
      <geometry><mesh filename="meshes/hull_femur.stl"/></geometry>
    </collision>
  </link>
  <link name="tibia_3">
    <inertial>
      <origin xyz="0.0794509441 -0.0005404937 -0.0000268868"/>
      <mass value="0.1952924260"/>
      <inertia ixx="7.16375396603e-05" ixy="-6.30207363729e-06" ixz="-3.81130343208e-09" iyy="0.000446757714147" iyz="-3.34732118895e-08" izz="0.00047516971597"/>
    </inertial>
    <visual>
      <geometry><mesh filename="meshes/tibia_l1__Tibia.stl"/></geometry>
      <material name="sandstone_dark"/>
    </visual>
    <visual>
      <geometry><mesh filename="meshes/tibia_l1__F6700ZZ_ElbowIdler.stl"/></geometry>
      <material name="metal"/>
    </visual>
    <visual>
      <geometry><mesh filename="meshes/tibia_l1__TactileSwitch_6x6.stl"/></geometry>
      <material name="metal"/>
    </visual>
    <visual>
      <geometry><mesh filename="meshes/tibia_l1__Tibia_Sleeve_Bottom.stl"/></geometry>
      <material name="sandstone"/>
    </visual>
    <visual>
      <geometry><mesh filename="meshes/tibia_l1__Tibia_Sleeve_Top.stl"/></geometry>
      <material name="sandstone"/>
    </visual>
    <visual>
      <geometry><mesh filename="meshes/tibia_l1__Knee_Cap.stl"/></geometry>
      <material name="sandstone"/>
    </visual>
    <visual>
      <geometry><mesh filename="meshes/tibia_l1__Claw_Foot.stl"/></geometry>
      <material name="sandstone"/>
    </visual>
    <visual>
      <geometry><mesh filename="meshes/tibia_l1__Plunger_Pin.stl"/></geometry>
      <material name="rubber"/>
    </visual>
    <collision>
      <geometry><mesh filename="meshes/hull_tibia.stl"/></geometry>
    </collision>
    <collision>
      <origin xyz="0.1622572343 0 0"/>
      <geometry><sphere radius="0.0120000000"/></geometry>
    </collision>
  </link>
  <joint name="sweep_3" type="revolute">
    <parent link="base_link"/>
    <child link="coxa_3"/>
    <origin xyz="-0.0818135621 -0.0594410323 0.0220000000" rpy="0 0 -2.5132741229"/>
    <axis xyz="0 0 1"/>
    <limit lower="-0.7853981634" upper="0.7853981634" effort="2.90" velocity="4.70"/>
    <dynamics damping="0.0100" friction="0.0500"/>
  </joint>
  <joint name="lift_3" type="revolute">
    <parent link="coxa_3"/>
    <child link="femur_3"/>
    <origin xyz="0.0420000000 0 0" rpy="0 0 0"/>
    <axis xyz="0 1 0"/>
    <limit lower="-1.3962634016" upper="1.4835298642" effort="2.90" velocity="4.70"/>
    <dynamics damping="0.0100" friction="0.0500"/>
  </joint>
  <joint name="elbow_3" type="revolute">
    <parent link="femur_3"/>
    <child link="tibia_3"/>
    <origin xyz="0.1300000000 0 0" rpy="0 0 0"/>
    <axis xyz="0 1 0"/>
    <limit lower="0.1745329252" upper="2.2689280276" effort="2.90" velocity="4.70"/>
    <dynamics damping="0.0100" friction="0.0500"/>
  </joint>
  <link name="coxa_4">
    <inertial>
      <origin xyz="0.0220536062 -0.0019426100 -0.0017121492"/>
      <mass value="0.0513195740"/>
      <inertia ixx="2.66251964914e-05" ixy="2.03394448522e-06" ixz="-1.75072383268e-06" iyy="2.59360418573e-05" iyz="2.06874025331e-08" izz="2.73187075064e-05"/>
    </inertial>
    <visual>
      <geometry><mesh filename="meshes/coxa_l1__Coxa_Bracket.stl"/></geometry>
      <material name="sandstone_dark"/>
    </visual>
    <visual>
      <geometry><mesh filename="meshes/coxa_l1__F6700ZZ_SweepIdler.stl"/></geometry>
      <material name="metal"/>
    </visual>
    <visual>
      <geometry><mesh filename="meshes/coxa_l1__F6700ZZ_LiftIdler.stl"/></geometry>
      <material name="metal"/>
    </visual>
    <visual>
      <geometry><mesh filename="meshes/coxa_l1__Shoulder_Cap.stl"/></geometry>
      <material name="sandstone"/>
    </visual>
    <collision>
      <geometry><mesh filename="meshes/hull_coxa.stl"/></geometry>
    </collision>
  </link>
  <link name="femur_4">
    <inertial>
      <origin xyz="0.0641940239 0.0000510935 0.0001382543"/>
      <mass value="0.3104070510"/>
      <inertia ixx="8.81913648521e-05" ixy="6.02727799994e-07" ixz="4.02792124591e-07" iyy="0.000816480742233" iyz="5.14032825426e-09" izz="0.000812937154262"/>
    </inertial>
    <visual>
      <geometry><mesh filename="meshes/femur_l1__Femur_Shell.stl"/></geometry>
      <material name="sandstone_dark"/>
    </visual>
    <visual>
      <geometry><mesh filename="meshes/femur_l1__STS3215_Lift.stl"/></geometry>
      <material name="metal"/>
    </visual>
    <visual>
      <geometry><mesh filename="meshes/femur_l1__STS3215_Elbow.stl"/></geometry>
      <material name="metal"/>
    </visual>
    <visual>
      <geometry><mesh filename="meshes/femur_l1__Horn_Lift.stl"/></geometry>
      <material name="metal"/>
    </visual>
    <visual>
      <geometry><mesh filename="meshes/femur_l1__Horn_Elbow.stl"/></geometry>
      <material name="metal"/>
    </visual>
    <visual>
      <geometry><mesh filename="meshes/femur_l1__Femur_Sleeve_Bottom.stl"/></geometry>
      <material name="sandstone"/>
    </visual>
    <visual>
      <geometry><mesh filename="meshes/femur_l1__Femur_Sleeve_Top.stl"/></geometry>
      <material name="sandstone"/>
    </visual>
    <collision>
      <geometry><mesh filename="meshes/hull_femur.stl"/></geometry>
    </collision>
  </link>
  <link name="tibia_4">
    <inertial>
      <origin xyz="0.0794509441 -0.0005404937 -0.0000268868"/>
      <mass value="0.1952924260"/>
      <inertia ixx="7.16375396603e-05" ixy="-6.30207363729e-06" ixz="-3.81130343208e-09" iyy="0.000446757714147" iyz="-3.34732118895e-08" izz="0.00047516971597"/>
    </inertial>
    <visual>
      <geometry><mesh filename="meshes/tibia_l1__Tibia.stl"/></geometry>
      <material name="sandstone_dark"/>
    </visual>
    <visual>
      <geometry><mesh filename="meshes/tibia_l1__F6700ZZ_ElbowIdler.stl"/></geometry>
      <material name="metal"/>
    </visual>
    <visual>
      <geometry><mesh filename="meshes/tibia_l1__TactileSwitch_6x6.stl"/></geometry>
      <material name="metal"/>
    </visual>
    <visual>
      <geometry><mesh filename="meshes/tibia_l1__Tibia_Sleeve_Bottom.stl"/></geometry>
      <material name="sandstone"/>
    </visual>
    <visual>
      <geometry><mesh filename="meshes/tibia_l1__Tibia_Sleeve_Top.stl"/></geometry>
      <material name="sandstone"/>
    </visual>
    <visual>
      <geometry><mesh filename="meshes/tibia_l1__Knee_Cap.stl"/></geometry>
      <material name="sandstone"/>
    </visual>
    <visual>
      <geometry><mesh filename="meshes/tibia_l1__Claw_Foot.stl"/></geometry>
      <material name="sandstone"/>
    </visual>
    <visual>
      <geometry><mesh filename="meshes/tibia_l1__Plunger_Pin.stl"/></geometry>
      <material name="rubber"/>
    </visual>
    <collision>
      <geometry><mesh filename="meshes/hull_tibia.stl"/></geometry>
    </collision>
    <collision>
      <origin xyz="0.1622572343 0 0"/>
      <geometry><sphere radius="0.0120000000"/></geometry>
    </collision>
  </link>
  <joint name="sweep_4" type="revolute">
    <parent link="base_link"/>
    <child link="coxa_4"/>
    <origin xyz="0.0312500000 -0.0961776105 0.0220000000" rpy="0 0 -1.2566370614"/>
    <axis xyz="0 0 1"/>
    <limit lower="-0.7853981634" upper="0.7853981634" effort="2.90" velocity="4.70"/>
    <dynamics damping="0.0100" friction="0.0500"/>
  </joint>
  <joint name="lift_4" type="revolute">
    <parent link="coxa_4"/>
    <child link="femur_4"/>
    <origin xyz="0.0420000000 0 0" rpy="0 0 0"/>
    <axis xyz="0 1 0"/>
    <limit lower="-1.3962634016" upper="1.4835298642" effort="2.90" velocity="4.70"/>
    <dynamics damping="0.0100" friction="0.0500"/>
  </joint>
  <joint name="elbow_4" type="revolute">
    <parent link="femur_4"/>
    <child link="tibia_4"/>
    <origin xyz="0.1300000000 0 0" rpy="0 0 0"/>
    <axis xyz="0 1 0"/>
    <limit lower="0.1745329252" upper="2.2689280276" effort="2.90" velocity="4.70"/>
    <dynamics damping="0.0100" friction="0.0500"/>
  </joint>
</robot>
