ryanrahman27/rocky/(commit log)

2026-09-13 Add the Fusion-derived simulation model
    MJCF, URDF and per-link meshes exported from the Rocky master model, plus the
    generator that produces them from the CAD export. Collision is one convex hull
    per link with explicit contact spheres at the five feet, placed so their lowest
    points reproduce the CAD stance exactly.
    Claude-Session: https://claude.ai/code/session_01LQETFtiLHz8XsQKNkU493a
    [base__Carapace.stl, base__Chassis.stl, base__Shoulder_Boot.stl, base__Shoulder_Boot_1.stl, base__Shoulder_Boot_2.stl, base__Shoulder_Boot_3.stl, base__Shoulder_Boot_4.stl, coxa_l1__Coxa_Bracket.stl]
2026-09-13 Add model parameters and leg kinematics
    model_params.py is the single source of truth for geometry, joint limits and
    servo constants; tests/test_model.py later asserts all of it against the
    compiled MJCF so the two cannot drift.
    The IK considers both sweep branches, so a foot behind the sweep axis -- what
    the manipulator limb does folding back over the body -- solves instead of being
    rejected 180 degrees away.
    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
2026-09-13 Add the wave gait
    One foot airborne at a time in the star order 0-2-4-1-3, which keeps
    consecutive swing legs 144 degrees apart and the body axis 78-102 mm inside the
    support polygon. Foot paths are planned as contact points in the body frame and
    solved through the leg IK.
    Measured open loop in MuJoCo: 41 mm/s against 52 mm/s commanded. The shortfall
    is servo compliance, not foot slip -- friction from mu=1 to mu=5 changes
    nothing, while kp=60 recovers 92%. docs/gait.md has the experiments.
    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
2026-09-13 Add the mjlab velocity task with gait-phase shaping
    Two additions to mjlab's velocity task carry the wave gait into RL: a gait
    clock in the observation, and a reward for each foot being on the ground when
    the schedule says it should be. The policy picks its own joint motion; only the
    timing is prescribed. An activity gate collapses the schedule to "all feet
    planted" when the command is near zero, so standing still is not punished.
    Initial state is the gait's neutral stance rather than the CAD pose, so actions
    are offsets from the posture the robot actually walks in. get_spec() strips the
    MJCF keyframe because mjlab only ever reads an entity's first one.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
2026-09-14 Rescale mjlab's velocity task onto Rocky's speed envelope
    The stock velocity task assumes a quadruped cruising at 1-3 m/s, and several of
    its numbers are in velocity units. Rocky tops out at 0.08 m/s, so they meant
    something entirely different here -- the first training run was commanded at
    +/-1.0 m/s and spent 70% of its time with feet off the ground, scoring below a
    robot that simply stands still.
    - command_vel curriculum overwrote lin_vel_x with (-1.0, 1.0) at step 0,
    discarding the configured range. Re-staged onto Rocky's envelope.
    - rel_forward_envs forced 20% of envs to clamp(min=0.3) -- hardcoded in the
    command term, unreachable whatever the ranges say. Disabled.
    - comm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
2026-09-14 Make the gait shaping actually compete with velocity tracking
    A 1100-iteration run tracked velocity at 98% of maximum while scoring 0.748 on
    the contact schedule -- below the 0.80 a robot gets for standing still -- with
    feet lifting 8 mm against a 30 mm target. The shaping was being outvoted.
    - gait_swing_clearance measured squared error in metres, so a 13 mm miss cost
    1.6e-4 and the term contributed -0.0008 whatever weight it carried. Now
    normalised by step height: a foot a full step off target costs 1.0.
    - gait_contact raised 1.0 -> 2.5. Velocity tracking offers 4.0 total, so at
    1.0 a shuffle that tracks well has no reason to reorganise into the gait.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
2026-09-14 Scale velocity tracking to Rocky's speed range
    The first policy learned the contact schedule (0.884) but stepped in place. It
    was behaving optimally: velocity tracking is exp(-error^2/std^2) with std sized
    for a 1-3 m/s quadruped, so at 0.08 m/s a robot standing perfectly still scored
    0.975 of maximum. Walking netted -0.09 reward -- the posture cost of striding
    (-0.14) exceeded the velocity gain (+0.05).
    Scaling each std by how far the command range shrank from the Go1 defaults
    (lin 1.0 -> 0.08, ang 0.5 -> 0.3) makes standing still score 0.018, and walking
    worth +1.82.
    Claude-Session: https://claude.ai/code/session_01LQETFtiLHz8XsQKNkU4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
2026-09-15 Teach the gait by imitation, and stop paying for stepping in place
    Measured through the RL environment, the analytic wave gait reaches 82-87% of
    every command including yaw. The policy trained against the contact schedule
    alone reached 11-30% forward and 0% yaw, while scoring 0.877 on that schedule --
    because the schedule constrains when a foot is down, not where it is placed, so
    stepping on the spot collects it in full.
    - gait_contact 2.5 -> 1.0: at 2.5 it was strong enough to fund that local
    optimum.
    - new gait_imitation term rewards matching the scripted gait's whole posture
    at this phase and this env's commanded velocity, which constrains placement.
    Separation measured i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
2026-09-15 Add scripts/eval_policy.py: measure displacement, not reward
    Reward curves repeatedly failed to say whether this robot was walking. Velocity
    tracking read 98% of maximum while it stood still; the contact schedule scored
    0.88 while it stepped on the spot. This rolls a controller out at nine fixed
    commands and measures net displacement, which no reward-shape error can fake.
    --scripted runs the analytic gait through the same harness as a baseline.
    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
2026-09-15 Add the trained policy's results, demo clips, and a blind rough-terrain task
    The policy beats the analytic gait it was taught from on every translation
    command (103-137% of commanded vs the reference's 82-87%) and matches it
    turning, measured by net displacement rather than reward.
    Mjlab-Velocity-Rough-Blind-Rocky is the rough task with the height-scan
    observations removed, so its observation layout matches the flat task and a
    flat-trained checkpoint runs on terrain unchanged -- blind locomotion, which is
    both a fair test of how far a flat gait carries and a reasonable thing to train.
    Claude-Session: https://claude.ai/code/session_01LQE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
2026-09-15 Manipulation: walk up to two cubes and stack them
    Leg 0 is both a leg and an arm. This adds the switch between those two
    roles, and everything the geometry demanded on the way.
    src/rocky/arm.py leg 0 as a 4-DOF arm. Forward kinematics agree with
    the compiled MJCF grasp site to 3e-12 m. The wrist's
    +-75 deg range means a straight-down grasp runs out at
    about 360 mm, so the solver scans the approach angles
    the joints will actually hold and takes the steepest.
    src/rocky/stack.py the scripted brace-and-stack sequence, closed on the
    measured base pose, with a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
    [hull_gripper_nojaws.stl]
2026-09-16 Blind: stack the cubes with sonar, proprioception and touch
    Eridians have no eyes. Rocky perceives shape by sound, which is why he
    could never see the stars and why everything he and Grace exchanged had
    to be handed over physically. Taking that seriously removes the cameras,
    and with them the case for a vision-language policy: there is no image to
    condition on.
    11 of 14 randomised episodes stacked on sonar, joint encoders, an IMU and
    two touch pads. Nothing in the pipeline reads a cube's true pose.
    model/add_manipulation.py 270 rangefinders in the five gaps between the
    limbs, five more past the fingertips, touch
    sites on both pad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
2026-09-16 Train a diffusion policy on 283 blind demonstrations
    320 episodes generated across two workers, randomised wider than the
    success envelope; 283 stacked and became the training set. The
    demonstrator's own rate on that spread is 88%.
    Closed loop over 30 fresh episodes the policy puts the red cube on the
    blue one and leaves it fully supported 19 times, 12 of them inside the
    strict 14 mm the script is scored by. It transfers and it is worse than
    what it was cloned from, which is where behaviour cloning usually lands.
    Open loop after 120 epochs, with 28 episodes held out entirely: median
    chunk error 0.22 mrad on training data and 0.23 mrad on data it has never
    seen. Nothing is being memorised,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
2026-09-16 Film the whole pipeline with the policy driving
    eval_diffusion.py could only start the robot already parked. --walk-in
    runs one continuous episode instead: sonar search, crabwise approach,
    brace, feel sweep, then the diffusion policy for the fifteen seconds of
    pick and place.
    Three shots, cut on the phase -- wide while it crosses the room, medium
    over the brace and the sweep, and a camera tracking gripper_0 for the
    manipulation, which is the part the policy is actually driving and was a
    speck in the corner of the body-tracking shot.
    Frames stream to the encoder rather than being buffered: a full-pipeline
    episode at 960x720 and 30 fps is two gigabytes of uint8 held in memory,
    against 7 GB o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
2026-09-16 Lead the README with the echolocation, not the walking
    The blind stacking was the most interesting thing in here and it was
    three quarters of the way down the page behind a wall of text. It is now
    the first thing you see: a 400x300 clip of the braced robot sweeping its
    gripper across the front, finding both cubes by sound, and stacking them.
    GitHub will not inline a committed mp4, so this is a GIF, cut to match
    the two gait clips already at the top -- same width, same weight. The
    rangefinder rays are thin high-contrast lines that change every frame and
    compress terribly: straight out of ffmpeg at 480 px the same segment came
    to 14 MB, and it took a 48-colour palette with dithering off to ge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
